montoyamoraga/atenu/panel/atenu-v-0-rev-a/atenu.scad

// atenu.scad

$fn = 32;

include <./atenu_panel.scad>

atenu_panel();
