montoyamoraga/atenu/panel/atenu-v-0-rev-a/versiones.scad

// versiones.scad

// version del panel de atenu, grabada en el panel. sigue la version de
// la placa con la que calza: v<mayor>.<menor> rev-<letra>
VERSION = "v0.1 rev-a";

ATENU_TEXTO = "atenu";
ATENU_HP = 5;

// versiones
//
// v0.1 rev-a: noviembre 2026. primer panel de atenu. agujeros para los
// dos potenciometros y los cuatro jacks de la placa atenu-v-0-rev-a.
// despues de probar el primer impreso, que calzo con la placa, se agrega
// un rebaje en la cara frontal alrededor de cada jack para que entren
// las tuercas
