montoyamoraga/atenu/hardware/atenu-v-0-rev-b/atenu-v-0-rev-b.kicad_pcb

## KiCad design hardware/atenu-v-0-rev-b/atenu-v-0-rev-b.kicad_pcb (2026-11-11)

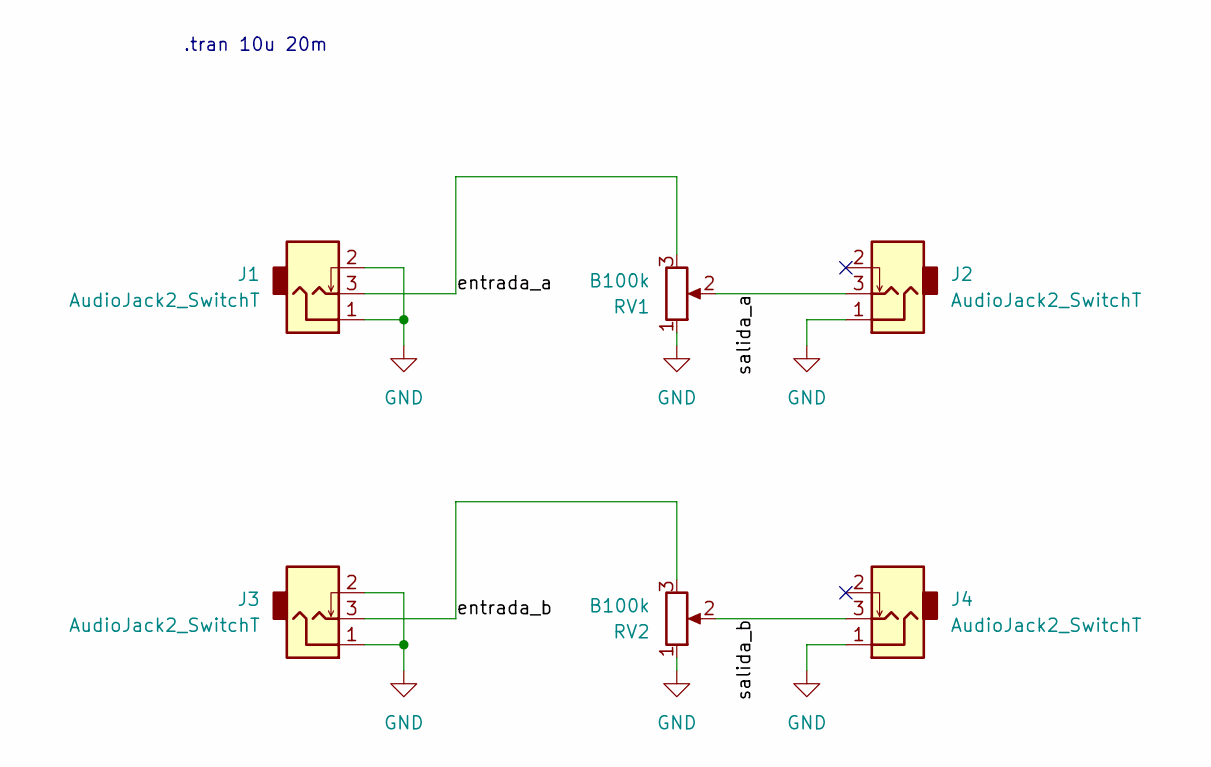
[picture p1: schematic atenu-v-0-rev-b.kicad_sch, atenu-v-0]

Parts:
J1, J2, J3, J4: AudioJack2_SwitchT; Jack_3.5mm_QingPu_WQP-PJ398SM_Vertical
RV1, RV2: B100k; Potenciometro_Alpha_RD901F_Vertical

Connections:
/entrada_a: J1.3, RV1.3
/entrada_b: J3.3, RV2.3
/salida_a: J2.3, RV1.2
/salida_b: J4.3, RV2.2
GND: J1.1, J1.2, J2.1, J3.1, J3.2, J4.1, RV1.1, RV2.1

Notes on the sheet:
.tran 10u 20m

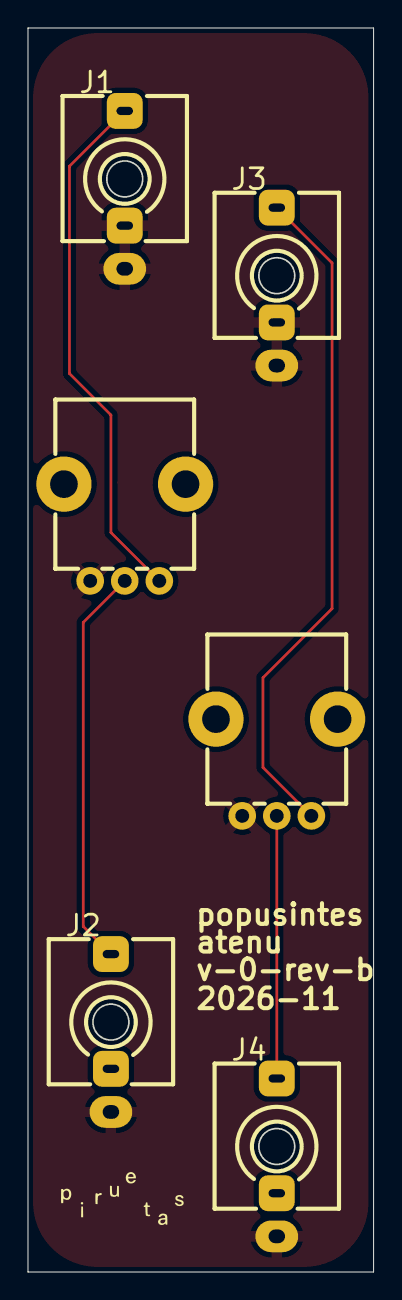
[picture p2: board atenu-v-0-rev-b.kicad_pcb from above]

Board: 2 copper layers, 25.0 x 90.0 mm, 6 parts (0 on the bottom side), 5 nets.
