montoyamoraga/atenu/(commit log)

2026-10-26 agregar v-0-rev-a
    [atenu-v-0-rev-a-B_Cu.gbr, atenu-v-0-rev-a-B_Mask.gbr, atenu-v-0-rev-a-B_Paste.gbr, atenu-v-0-rev-a-B_Silkscreen.gbr, atenu-v-0-rev-a-Edge_Cuts.gbr, atenu-v-0-rev-a-F_Cu.gbr, atenu-v-0-rev-a-F_Mask.gbr, atenu-v-0-rev-a-F_Paste.gbr]
2026-11-10 agregar panel
    [atenu.scad, atenu_panel.scad, versiones.scad]
2026-11-11 agregar rev-b
    [atenu-v-0-rev-b.kicad_pcb, atenu-v-0-rev-b.kicad_sch]
2026-11-11 Actualizar capturas y BOM de esquemáticos y placas [skip ci]
2026-11-11 agregar texto en parte de atras
    [atenu-v-0-rev-b.kicad_pcb]
2026-11-11 agregar texto popusintes
    [atenu-v-0-rev-b.kicad_pcb]
2026-11-11 agregar archivos de fabricacion
    [atenu-v-0-rev-b-B_Cu.gbr, atenu-v-0-rev-b-B_Mask.gbr, atenu-v-0-rev-b-B_Paste.gbr, atenu-v-0-rev-b-B_Silkscreen.gbr, atenu-v-0-rev-b-Edge_Cuts.gbr, atenu-v-0-rev-b-F_Cu.gbr, atenu-v-0-rev-b-F_Mask.gbr, atenu-v-0-rev-b-F_Paste.gbr]
